config101/Bravo/README.md

# Bravo
Bravo is an 8bit computer project derived from Minimal CPU System by Carsten Herting (SLU4) and based on some concepts from Ben Eater's 8bit computer. Bravo has been developed in modules as an educational and fun  project for people who are interested in building Homebrew computers. The project is presented in a series of videos which goes through logical design, hardware development, testing and programming.

Links:
Projects YouTune Channel:
https://www.youtube.com/channel/UCHP1mo5YA1Gy9c50hQemrQw

The complete Kit or PCBs for the project are available at:
https://8bitkits.com

Minimal CPU System by Carsten Herting (SLU4)
https://www.youtube.com/channel/UCXYQcMpUBT3aaQKfmAVJNow
https://github.com/slu4coder/Minimal-UART-CPU-System
https://minimal-cpu-system.boards.net/

Ben Eater's 8bit Computer
https://eater.net/
https://www.youtube.com/channel/UCS0N5baNlQWJCUrhCEo8WlA

## Update - April 2026
All PCB Gerber files have been released as part of this repository free of charge.You now have everything needed to build the project on your own.So, If you prefer, you can order PCBs using the provided files and source the parts yourself to complete the build.

A limited number of kits are still available in our store if you want to purchase all PCBs and parts at once and support the project. Thanks to the many fellow builders who have supported this project over the last couple of years.

Happy building!
Kaveh (CONFIG101)
