config101/Bravo/Bravo-V1.0/Slides/Flash Programmer.pptx

Method 1

Flash Memories in Bravo Project

1 x SST39SF040

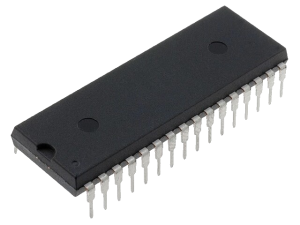
[picture p1: figure]

- 512 KB
- Memory Module

OS
Assembler

2 x SST39SF010

- 128 KB
- Control Logic

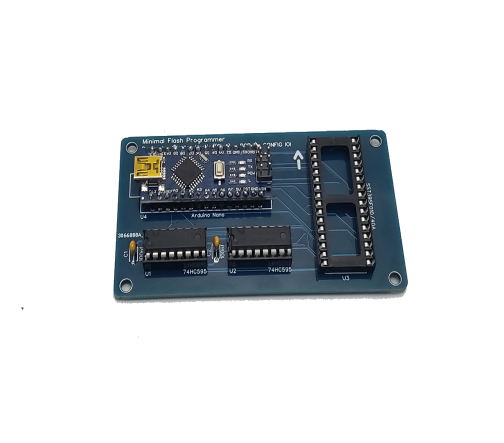
[picture p2: figure]
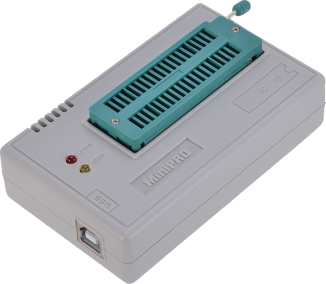
[picture p3: figure]

Micro Code

OR

Method 2

Files
Programs

File System
(Part of OS)

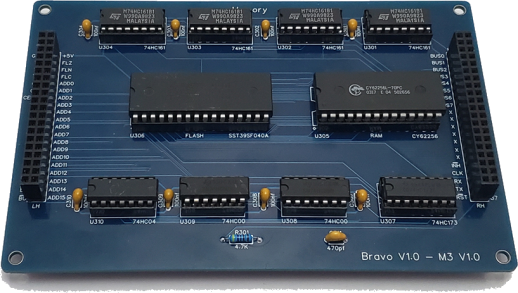
[picture p4: figure]
