config101/Bravo/Bravo-V1.0/Slides/Control Logic.pptx

## What is the Control Logic ?

Part of the computer that is outputting the Control Signals based on each specific instruction.
So far we have been using our Arduino Mega Shield to set the control signals to High/Low
We are building the control logic to output the required Control signals for each specific instruction.

## How a computer execute programs ?

Program Counter
When the computer starts, Program counter starts counting from 0
With each step, the value is put on the BUS
Signal : CO

Memory Address Register
MAR reads the value from the BUS and set the Address to the value
Signal : MI

Next Step
Signal : CE

Memory (FLASH/RAM)
Outputs the content of memory address on the BUS
Signal : RO

Flag Register
The Status of Flags saved into this register
Signal : FI

Instruction register
BUS content is the next instruction to be executed
Signal : II

Output is Addressing a ROM

Control ROM

CE ME CI CO AI AO BI BO MI RO FI EO .…..

Control Logic

Micro Step Counter
A counter that counts micro steps

## Control Logic in Bravo

Flag Register
The Status of Flags saved into this register (3 Bits)
Signal : EOFI

Instruction register
BUS content is the next instruction to be executed (6 Bits)
Signal : HI + CEME = II

Control ROMs


8 Signals

Control Logic

Micro Step Counter
A counter that counts micro steps (4 Bits)

2 x SST39SF010
Each 128 KB

MSB

8 Signals

LSB

CE ME CI CO AI AO BI BO MI RO FI EO .…..

## How Bravo execute programs ?

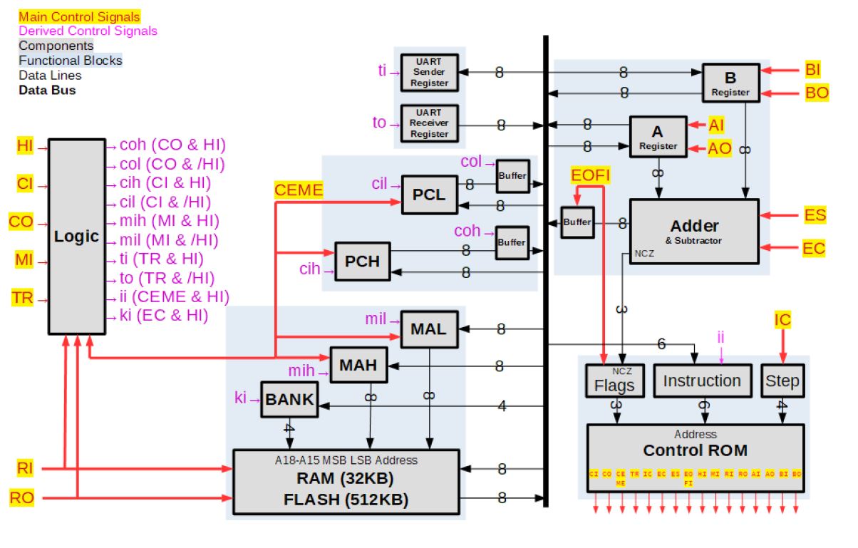
[picture p9: figure]

Fetch Instruction

1. CO , MI
2. CO, MI, HI
3. RO, HI, CEME

1. CO , MI
2. CO, MI, HI
3. RO, HI, CEME
4. RO, AI, CEME,IC

Example: LDI

## What is a program ?

2

Program
to add
X & Y

- Load X value directly into A register
- Load Y value from memory and ADD it
- Output the result

Instructions

LDI 10

Instruction

1

Operand
(Value of X)

ADD 01 80

3

OUT

Instruction
(Mnemonics used in programming)

Operand
(Memory Location, Contains Y)

LDI 10

Signals

Micro steps

1. CO , MI
2. CO, MI, HI
3. RO, HI, CEME
4. RO, AI, CEME,IC

1. Load value of 10 directly to A register
2. Load the Value of memory Address 8001(HEX) into B register
3. Output the content of the BUS

## Microcode in Bravo

+

+

0000 (4 bits)

4 + 13 bits

Total of 17 bits , addressing ROMs using 17 address lines

Flags (3 bits)
8 possible combinations

Instruction(6 bits)
64 different instructions

Micro Steps(4 bits)
16 Micro steps

Each Instruction is assigned a binary value, For Example
LDI is assigned value of 14
STA is assigned value 21
Etc..

Mnemonic | Filler Bits (4 Bits) | Flags (3 Bits) | Instruction (6 Bits) | Steps (4Bits) | | Control Signal
LDI | 0000 | 000 | 001110 | 0000 | Step0 | CO, MI
LDI | 0000 | 000 | 001110 | 0001 | Step1 | CO,MI,HI
LDI | 0000 | 000 | 001110 | 0010 | Step2 | RO,HI,CEME
LDI | 0000 | 000 | 001110 | 0011 | Step3 | RO,AI,CEME,IC
LDI | 0000 | 000 | 001110 | 0100 | Step4 | -
LDI | 0000 | 000 | 001110 | 0101 | …. | -

## Microcode in Bravo

LDA 101001 Step0 0000 CO|MI
LDA 101001 Step1 0001 CO|MI|HI
LDA 101001 Step2 0010 RO|HI|CEME
LDA 101001 Step3 0011 RO|BI|CEME
LDA 101001 Step15 1111 .

LDA 101001 Step0 0000 CO|MI
LDA 101001 Step1 0001 CO|MI|HI
LDA 101001 Step2 0010 RO|HI|CEME
LDA 101001 Step3 0011 RO|BI|CEME
LDA 101001 Step15 1111 .

LDA 101001 Step0 0000 CO|MI
LDA 101001 Step1 0001 CO|MI|HI
LDA 101001 Step2 0010 RO|HI|CEME
LDA 101001 Step3 0011 RO|BI|CEME
LDA 101001 Step15 1111 .

3 Flags
(8 combinations)

000
001
010

x

x

Flags (3 bits)
8 possible combinations

Instruction(6 bits)
64 different instructions

Micro Steps(4 bits)
16 Micro steps

8192 Total Micro Instructions , 8K
