config101/Bravo/Bravo-V1.0/BOM/Bravo_V1.0_BOM.xlsx

Item | Description | Footprint | QTY
74HC00 | IC | DIP-14_W7.62MM_SOCKET | 6
74HC02 | IC | DIP-14_W7.62MM_SOCKET | 1
74HC04 | IC | DIP-14_W7.62MM_SOCKET | 4
74HC08 | IC | DIP-14_W7.62MM_SOCKET | 3
74HC161 | IC | DIP-16_W7.62MM_SOCKET | 12
74HC164 | IC | DIP-14_W7.62MM_SOCKET | 2
74HC165 | IC | DIP-16_W7.62MM_SOCKET | 2
74HC173 | IC | DIP-16_W7.62MM_SOCKET | 6
74HC174D | IC | DIP-16_W7.62MM_SOCKET | 1
74HC193 | IC | DIP-16_W7.62MM_SOCKET | 1
74HC245 | IC | DIP-20-2.54MM | 6
74HC283 | IC | DIP-16_W7.62MM_SOCKET | 2
74HC86 | IC | DIP-14_W7.62MM_SOCKET | 2
Ceramic Capacitor 100nf | Ceramic Capacitor | CAP-TH_L4.0-W2.5-P5.00-D1.0 | 42
Ceramic Capacitor 470pf | Ceramic Capacitor | CAP-TH_L4.0-W2.5-P5.00-D1.0 | 2
Ceramic Capacitor 100pf | Ceramic Capacitor | CAP-TH_L4.0-W2.5-P5.00-D1.1 | 1
Electrolytic Capacitor 47 mf | Electrolytic Capacitor | CAP-TH_BD5.0-P2.50-D1.0-FD | 1
CRYSTAL 3.6864 MHz | Crystal | CRYSTAL 1MHZ | 1
CY62256 | RAM | PDIP-28_L37.0-W13.5-P2.54-LS15.6-BL | 1
DIP 14 IC Socket | IC Socket | DIP-14_W7.62MM_SOCKET | 19
DIP 16 IC Socket | IC Socket | DIP-16_W7.62MM_SOCKET | 24
DIP 20 IC Socket | IC Socket | DIP-20-2.54MM | 6
DIP 28 IC Socket | IC Socket | PDIP-28_L37.0-W13.5-P2.54-LS15.6-BL | 1
DIP 32 IC Socket | IC Socket | PDIP-32_L42.0-W13.7-P2.54-LS15.2-BL | 3
Header Female 2x20 | Header Female 2x20 | HEADER-2X20-2.54 | 2
Header Female Stackable 2x20 (40 pins) - Long Pins | Header Female 2x20 Long | HEADER-2X20-2.54 | 12
Header Male 1x40 | Header Male 1x40 | Header Male 1x40 | 5
Header Pin Jumper | Clock Rate Selector - Jumper |  | 1
LED 5 MM BLUE | LED | LED5MM | 20
LED 5 MM GREEN | LED | LED5MM | 10
LED 5 MM RED | LED | LED5MM | 20
LED 5 MM YELLOW | LED | LED5MM | 20
Resistor 4.7K Ohm | Resistor | AXIAL-0.4 | 4
Resistor Array 470 Ohm 8 Resistors (9 Pins)-Bussed | Buss Resitor Array | HDR-M-2.54_1X9 | 9
SST39SF010A | ROM FLASH (LSB - MSB) | DIP-32_600MIL | 2
SST39SF040A | ROM FLASH Storage | PDIP-32_L42.0-W13.7-P2.54-LS15.2-BL | 1
Tactile Switch | System Reset Tactile Switch | TACTILE-PTH | 4
PCB | PCB |  | 7
FT232RL FTDI Mini USB to TTL Serial |  |  | 1
Nylon Hex Standoff Female to Female (M3X20) | Spacer |  | 4
Nylon Hex Standoff M3 Female to Male 6mm+6mm | Spacer |  | 4
