config101/Bravo/(threads)

Thread 1 (2022-01-22):

Ref: Microcode bug in ADB

paulscottrobson, 2022-01-22:
As per https://github.com/slu4coder/Minimal-UART-CPU-System/issues/3

Closed 2022-03-22.

Thread 2 (2022-03-21):

Releasing PCB layout files?

joelburton, 2022-03-21:
This is a really interesting project, and I've been enjoying the videos a lot.

Given the educational nature of this (and the fact you've licensed it as CC0), I was hoping to be able to find the PCB design files. It's helpful for me when debugging something I've put together, and it can also help us connect the physical boards to the schematics. It looks like the EasyEDA files don't have the PCBs in them (or perhaps I'm not looking at them properly?)

If your goal is to generate income from sales of the PCBs, I understand & can respect that. Perhaps just some screenshots of the boards and the routing can be provided? That can discourage people from bypassing buying them, but provide a lot of the understanding-the-system benefits.

config101, 2022-03-22:
Hi Joel,
Thanks for your comment and I'm glad you are enjoying the videos.
You are right, the PCB files are not included in the EasyEDA files. 
While the project and all related circuits are licensed under Creative Commons, the PCBs are not. At this point, PCBs are commercial products sold at www.8bitkits.com.
This is really not about generating income from the project.The proceeds from the sale of PCBs/Kits are going into supporting current/future projects. Developing these PCBs has taken numerous hours of work and I went through 3 different prototypes/revisions over several months to come up with the final version that is all accurate and bug free.
Now, I have a plan to eventually release all the files which requires removing commercial markings from PCBs. That may happen in near future.
Here was my thought; if someone is hands on enough with building PCBs, all the schematics are available to do so. but If someone does not want to go that route, the PCBs are available for purchase and frankly the price that I'm offering the PCB sets at 8bitkits.com would probably be 30 to 40 percent less than cost of ordering PCBs from china (after cost of PCBs and shipping costs).
Anyhow, if you need the screenshots of the PCBs, I probably can take them. Just send me an email : support at 8bitkits.com and I will reply to that.
Thanks
CONFIG IOI 
      
On 3/20/2022 5:59:03 PM, Joel Burton ***@***.***> wrote:
This is a really interesting project, and I've been enjoying the videos a lot.
Given the educational nature of this (and the fact you've licensed it as CC0), I was hoping to be able to find the PCB design files. It's helpful for me when debugging something I've put together, and it can also help us connect the physical boards to the schematics. It looks like the EasyEDA files don't have the PCBs in them (or perhaps I'm not looking at them properly?)
If your goal is to generate income from sales of the PCBs, I understand & can respect that. Perhaps just some screenshots of the boards and the routing can be provided? That can discourage people from bypassing buying them, but provide a lot of the understanding-the-system benefits.
—
Reply to this email directly, view it on GitHub [https://github.com/config101/Bravo/issues/2], or unsubscribe [https://github.com/notifications/unsubscribe-auth/AW7G3VQOFPYSAAGVJIUGZDDVA7CVNANCNFSM5RGJHXAQ].
Triage notifications on the go with GitHub Mobile for iOS [https://apps.apple.com/app/apple-store/id1477376905?ct=notification-email&amp;mt=8&amp;pt=524675] or Android [https://play.google.com/store/apps/details?id=com.github.android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].
You are receiving this because you are subscribed to this thread.Message ID: ***@***.***>
[25719101-5271-41e2-b09a-881d1d001396]

Closed 2022-03-22.
