config101/Bravo/Bravo-V1.0/Schematic-PDFs/Schematic_Minimal Flash Programmer_2021_12_21.pdf

A | A

1

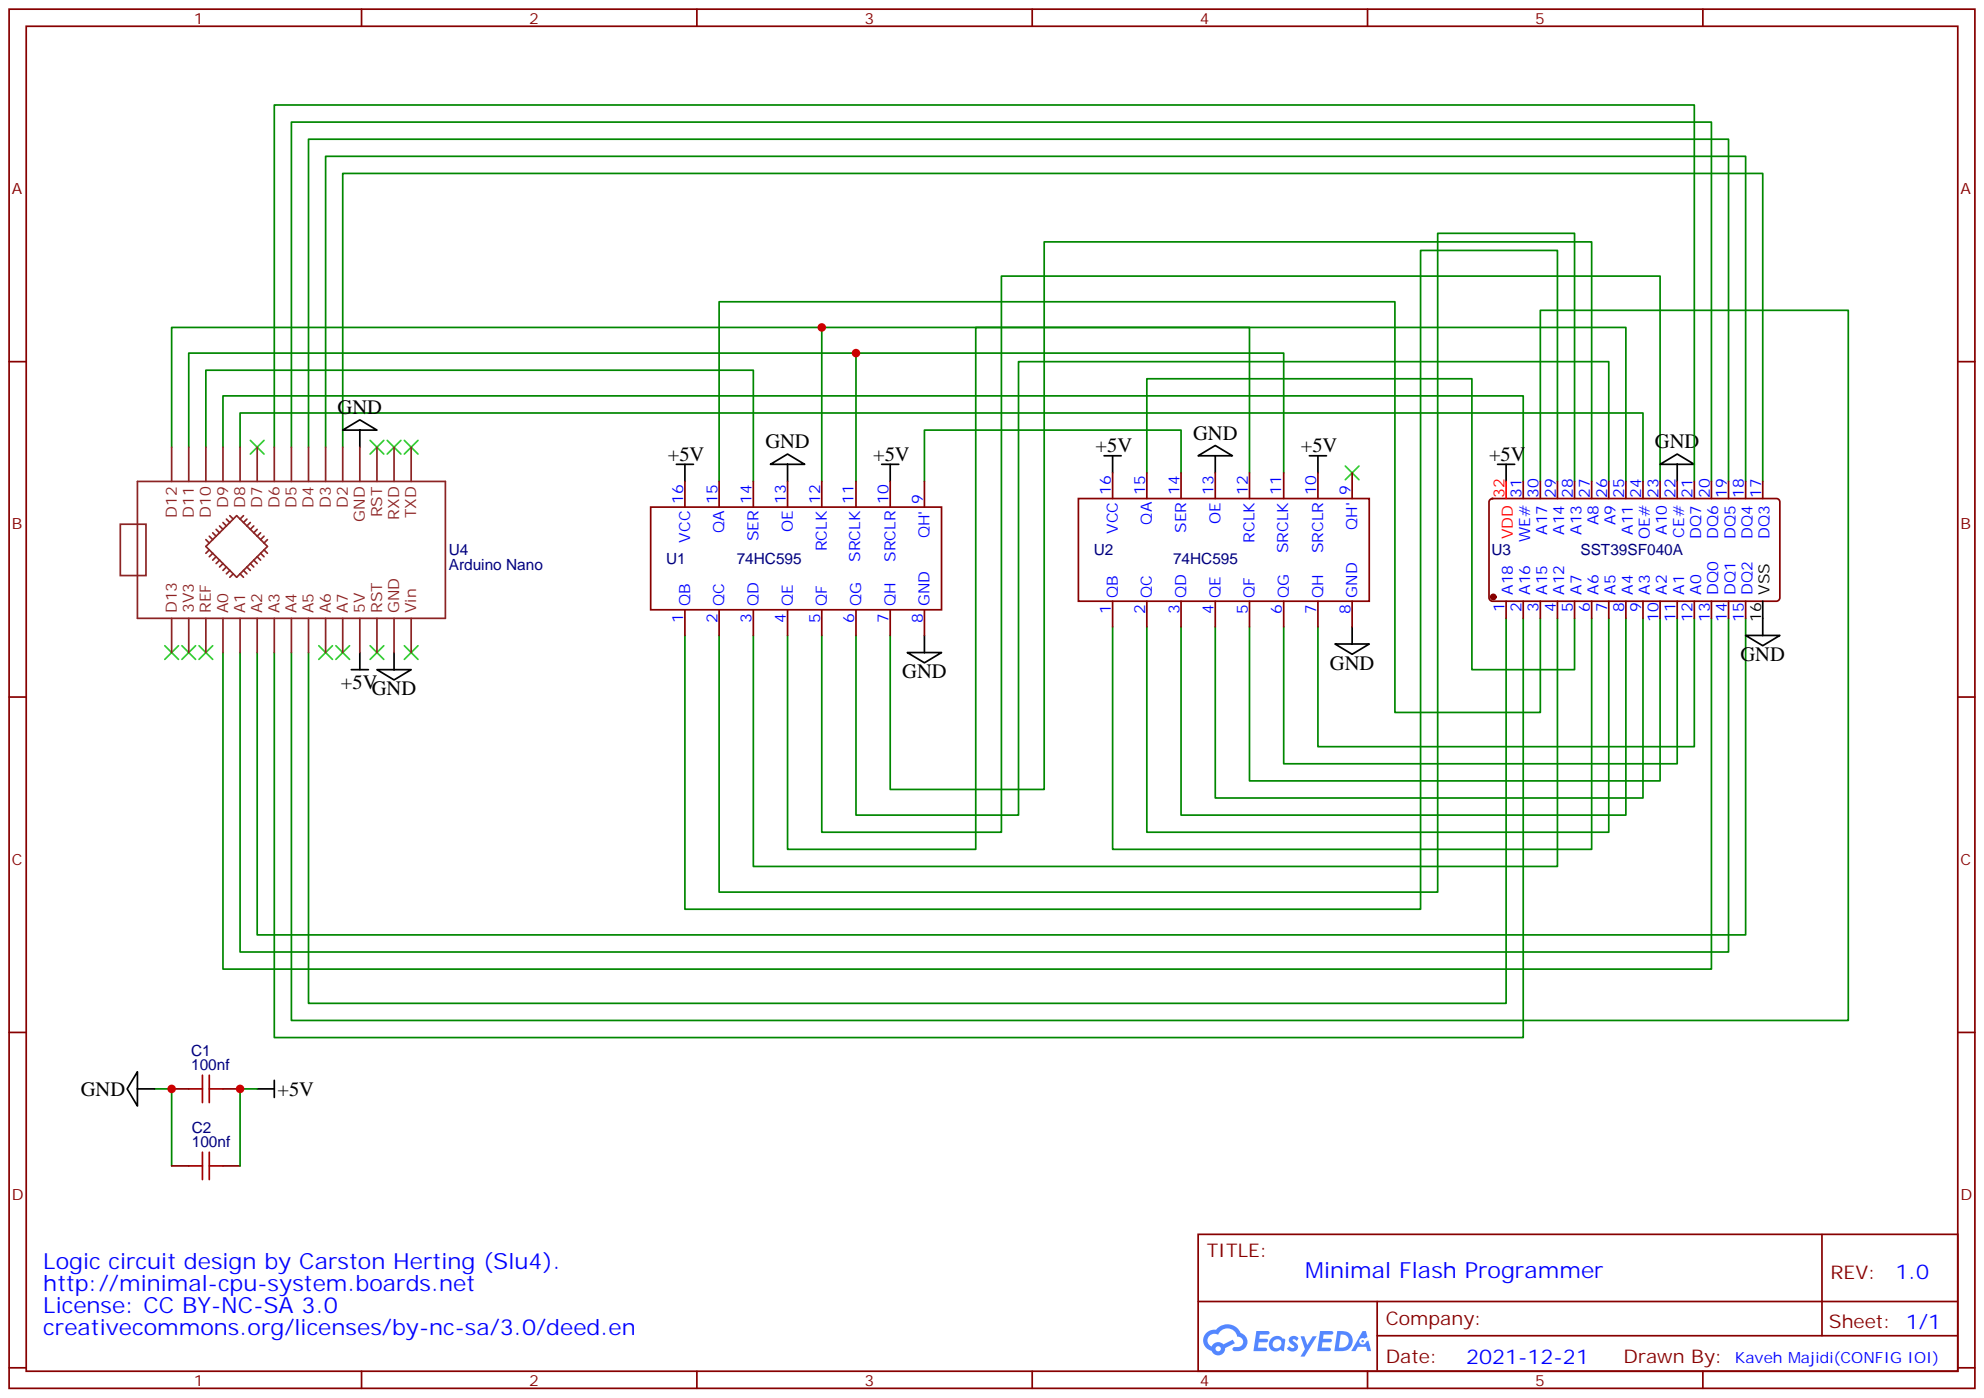
[picture p10: page 1]

VSS 16 DQ3 17 DQ4 18 DQ5 19 DQ6 20 DQ7 21 CE# 22 A10 23 OE# 24 A11 25 A9 26 A8 27 A13 28 A14 29 A17 30 WE# 31 VDD 32

Logic circuit design by Carston Herting (Slu4).
http://minimal-cpu-system.boards.net
License: CC BY-NC-SA 3.0
creativecommons.org/licenses/by-nc-sa/3.0/deed.en

Drawn By: Kaveh Majidi(CONFIG IOI)
