config101/Bravo/Bravo-V1.0/Schematic-PDFs/Schematic_Bravo-M1-Clock-and-Program Counter_2021-12-18.pdf

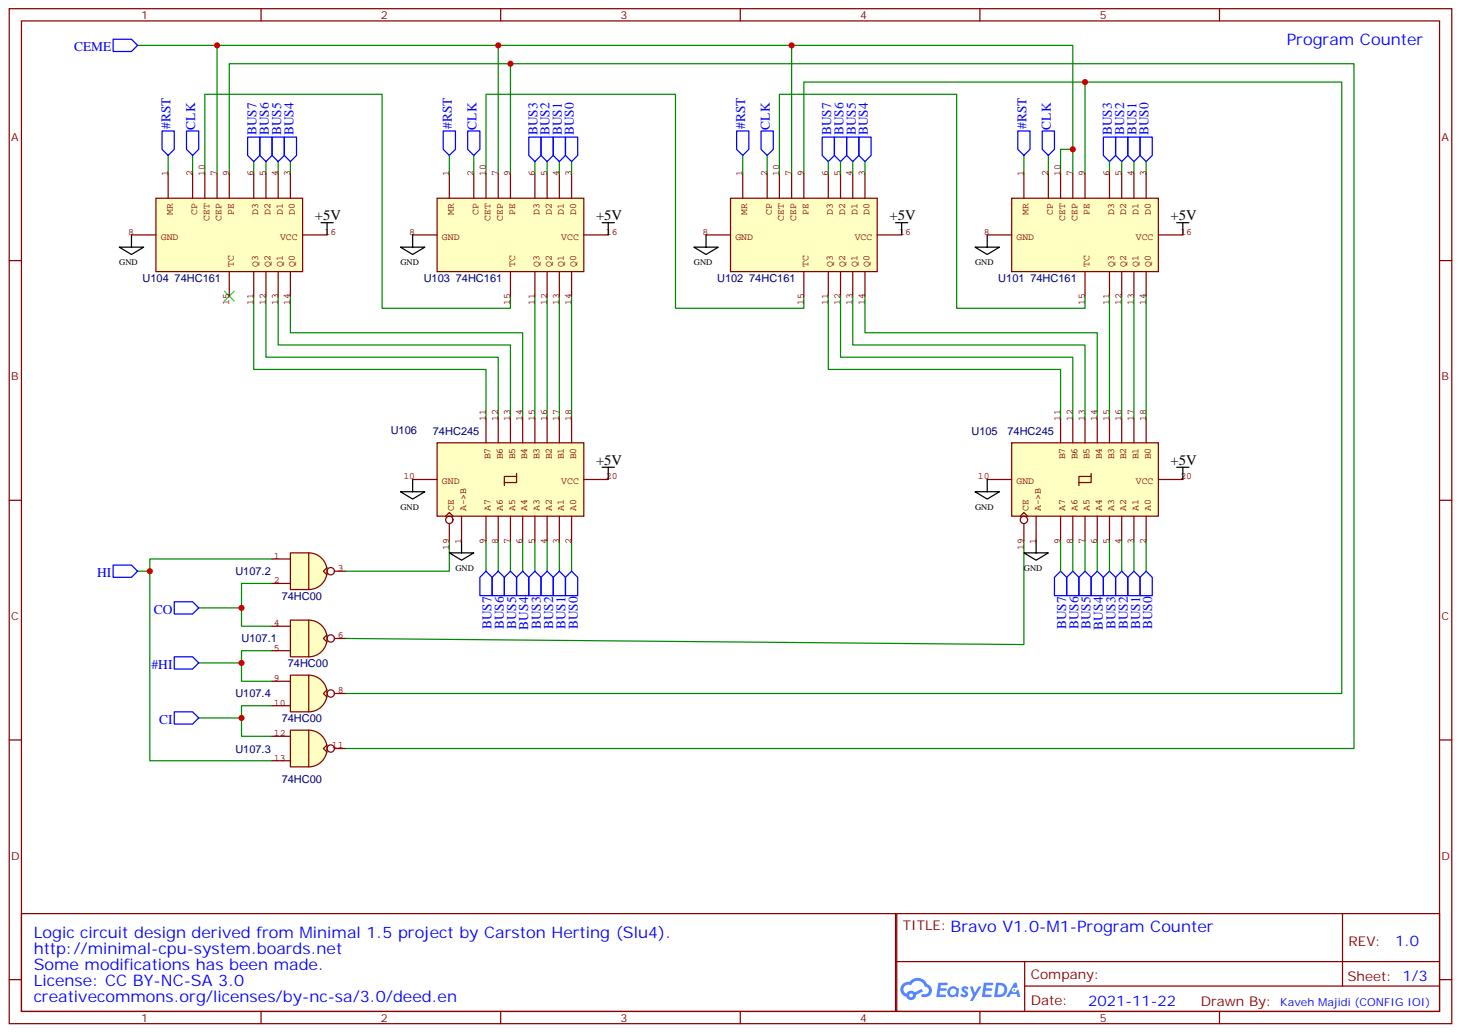
[picture p16: page 1]

TITLE: Bravo V1.0-M1-Program Counter

Logic circuit design derived from Minimal 1.5 project by Carston Herting (Slu4).
http://minimal-cpu-system.boards.net
Some modifications has been made.
License: CC BY-NC-SA 3.0
creativecommons.org/licenses/by-nc-sa/3.0/deed.en

Drawn By: Kaveh Majidi (CONFIG IOI)

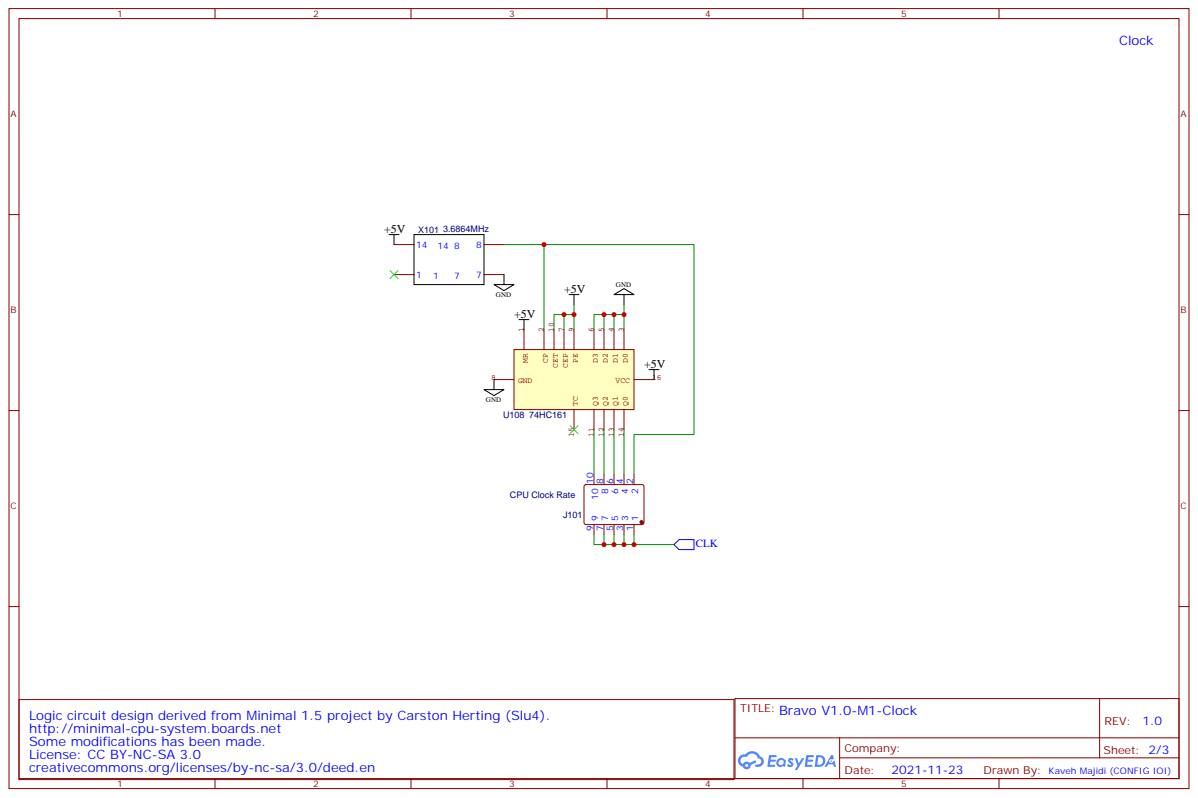
[picture p17: page 2]
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

39 39 40 40 38 38 36 36 34 34 32 32 30 30 28 28 26 26 24 24 22 22 20 20 18 18 16 16 14 14 12 12 10 10 8

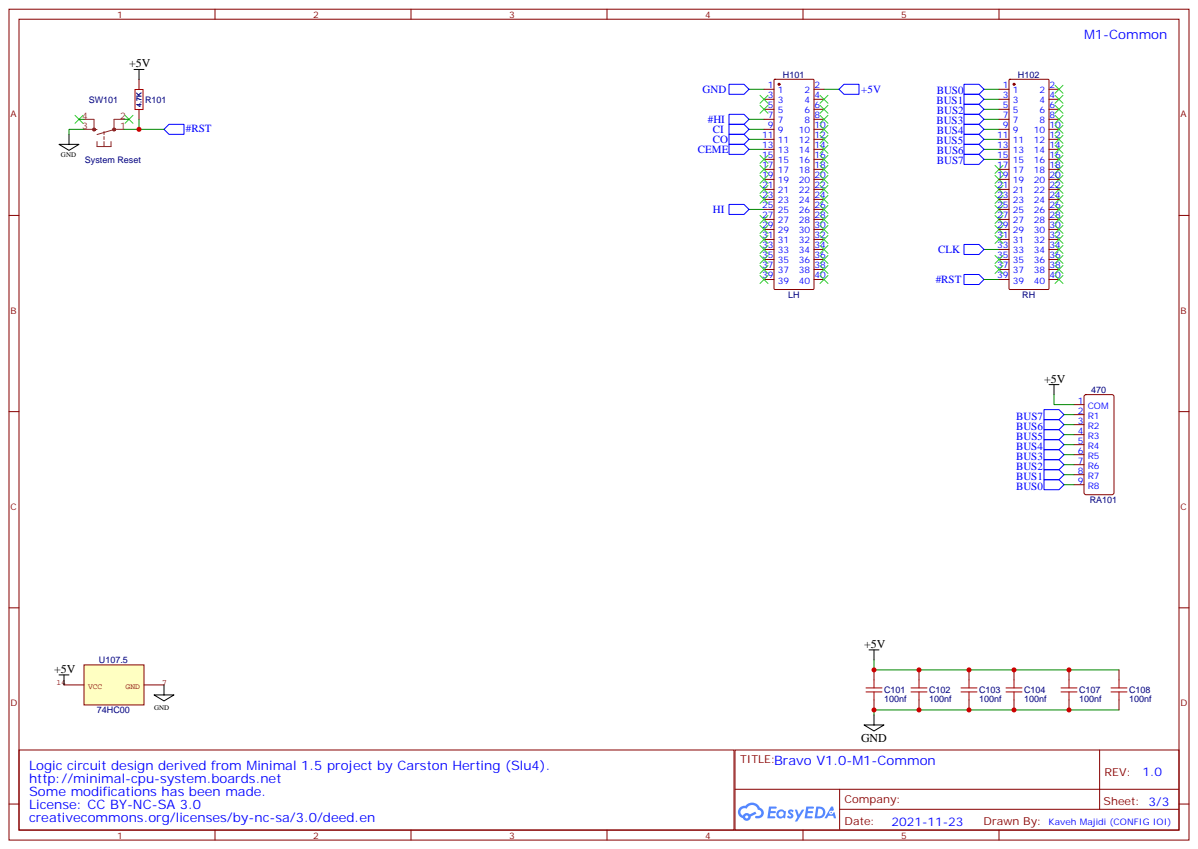
[picture p18: page 3]
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
