config101/Bravo/Bravo-V1.0/Schematic-PDFs/Schematic_Bravo-M3-Memory_2021-12-18.pdf

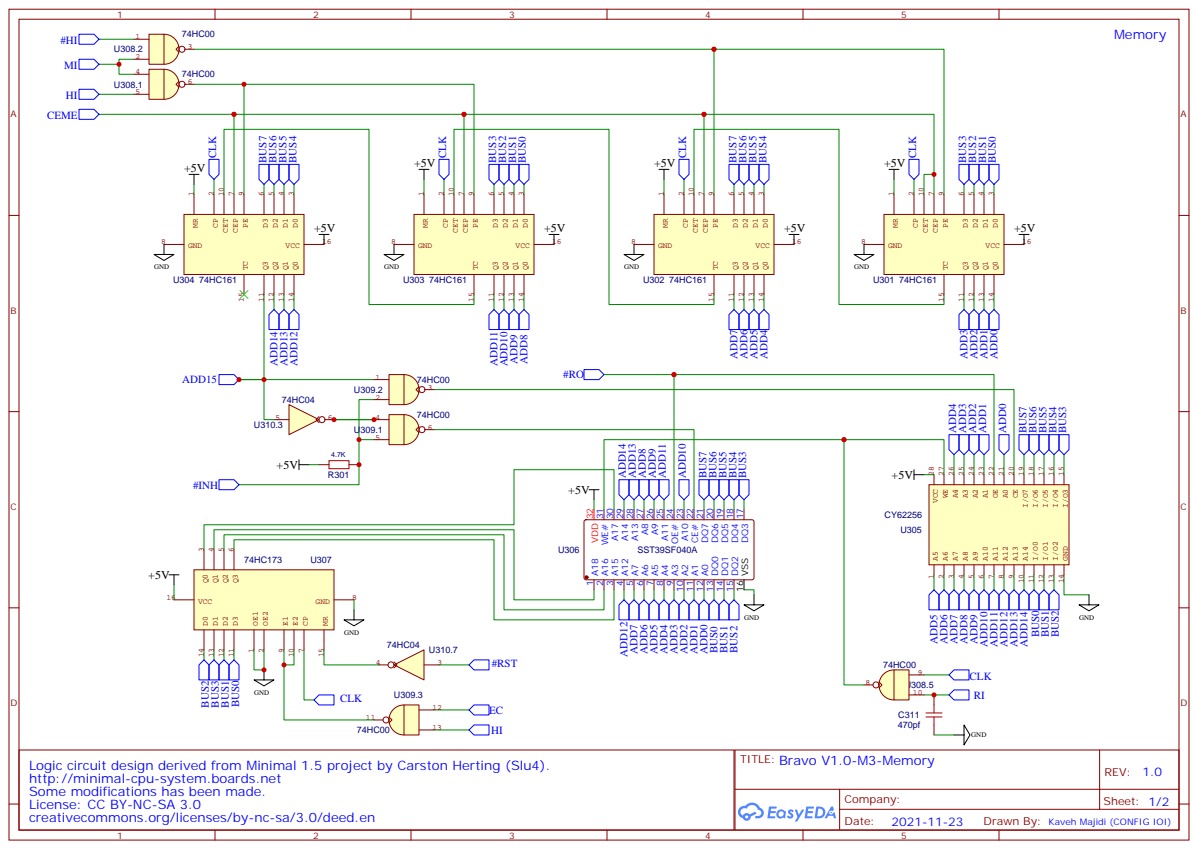
[picture p19: page 1]

VSS 16 DQ3 17 DQ4 18 DQ5 19 DQ6 20 DQ7 21 CE# 22 A10 23 OE# 24 A11 25 A9 26 A8 27 A13 28 A14 29 A17 30 WE# 31 VDD 32

Logic circuit design derived from Minimal 1.5 project by Carston Herting (Slu4).
http://minimal-cpu-system.boards.net
Some modifications has been made.
License: CC BY-NC-SA 3.0
creativecommons.org/licenses/by-nc-sa/3.0/deed.en

Drawn By: Kaveh Majidi (CONFIG IOI)

39 39 40 40 38 38 36 36 34 34 32 32 30 30 28 28 26 26 24 24 22 22 20 20 18 18 16 16 14 14 12 12 10 10 8

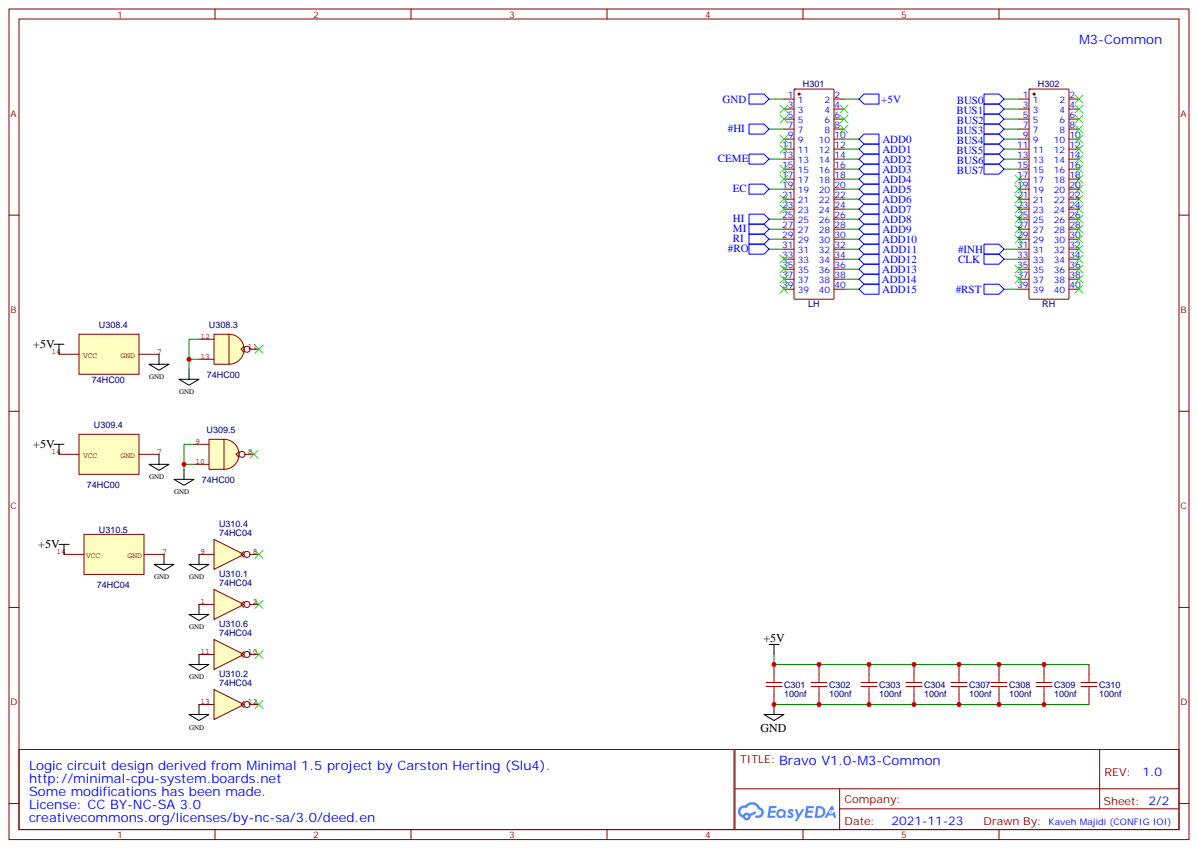
[picture p20: page 2]
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

Drawn By: Kaveh Majidi (CONFIG IOI)
