config101/Bravo/Bravo-V1.0/Schematic-PDFs/Schematic_Bravo-M6-LED Board_2021-12-18.pdf

A register | B Register

## Address BUS

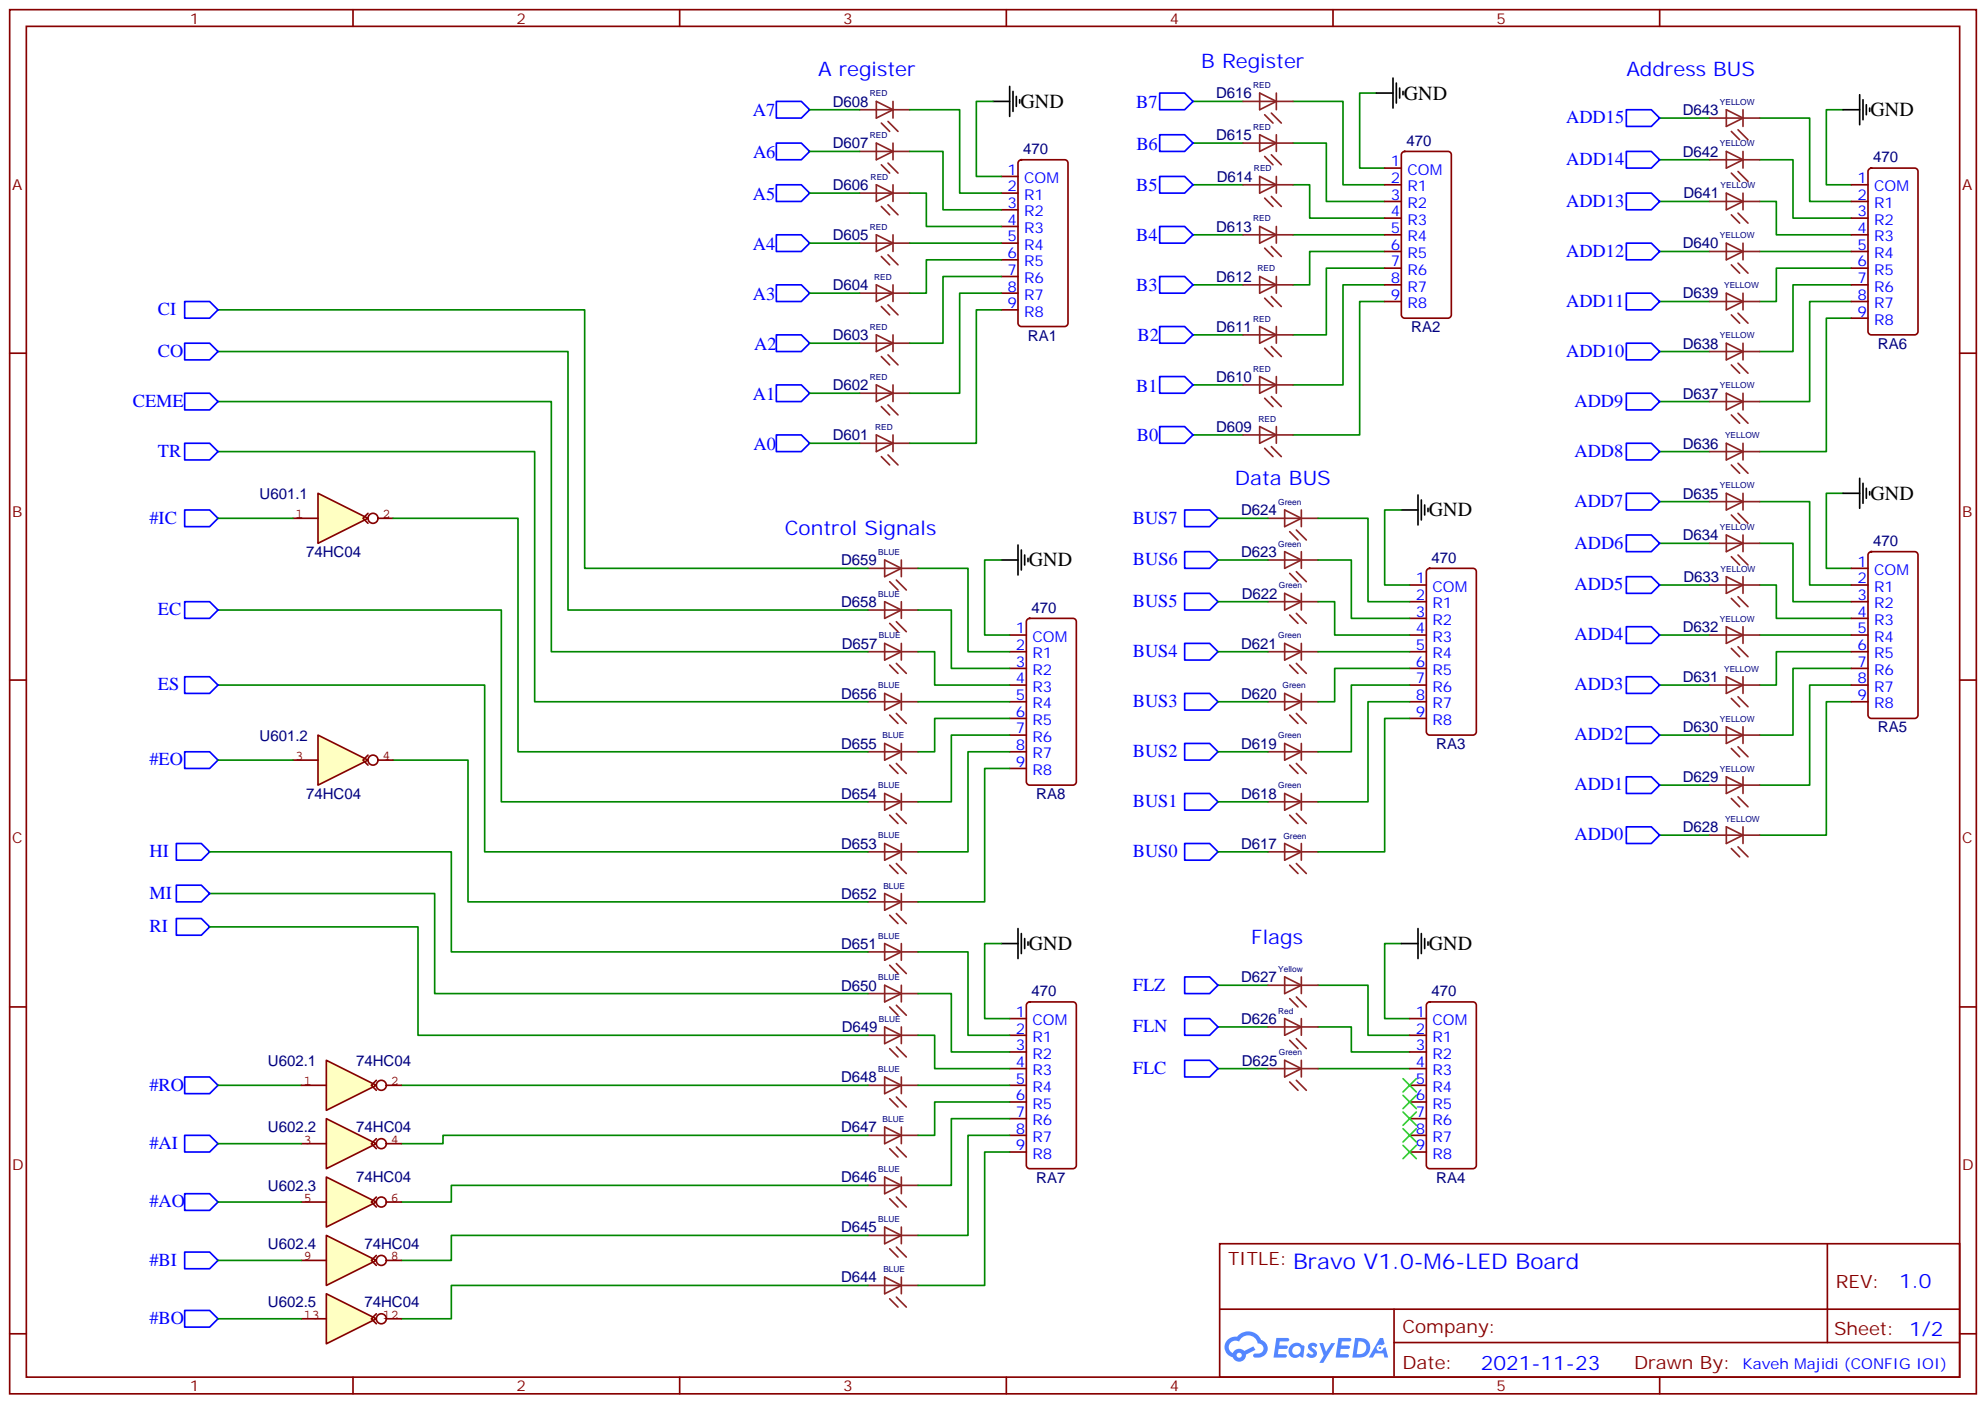
[picture p26: page 1]

TITLE: Bravo V1.0-M6-LED Board

Drawn By: Kaveh Majidi (CONFIG IOI)

39 39 | 40 40 38 38 36 36 34 34 32 32 30 30 28 28 26 26 24 24 22 22 20 20 18 18 16 16 14 14 12 12 10 10 8
39 39 | 40 40 38 38 36 36 34 34 32 32 30 30 28 28 26 26 24 24 22 22 20 20 18 18 16 16 14 14 12 12 10 10 8

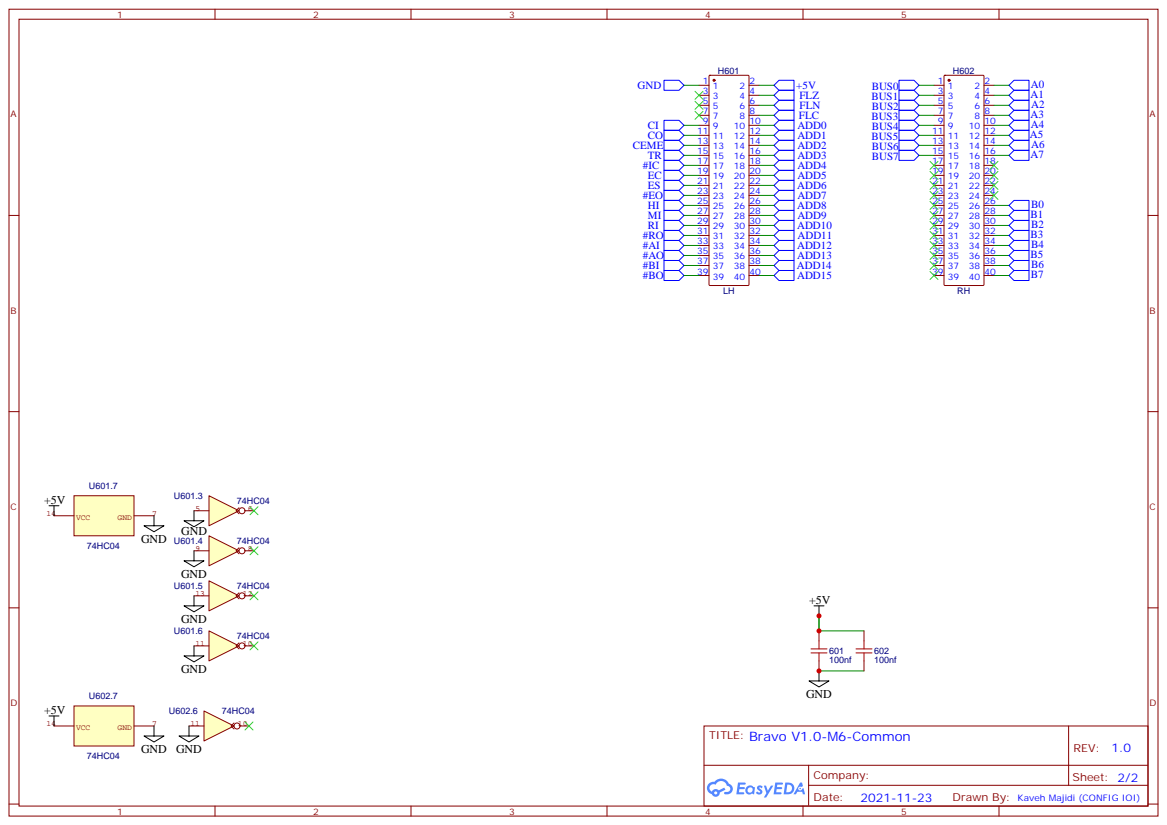
[picture p27: page 2]

Drawn By: Kaveh Majidi (CONFIG IOI)
