config101/Bravo/Bravo-V1.0/Schematic-PDFs/Schematic_Bravo-M7-Arduino Mega Shield_2021-12-18.pdf

## Arduino Shield

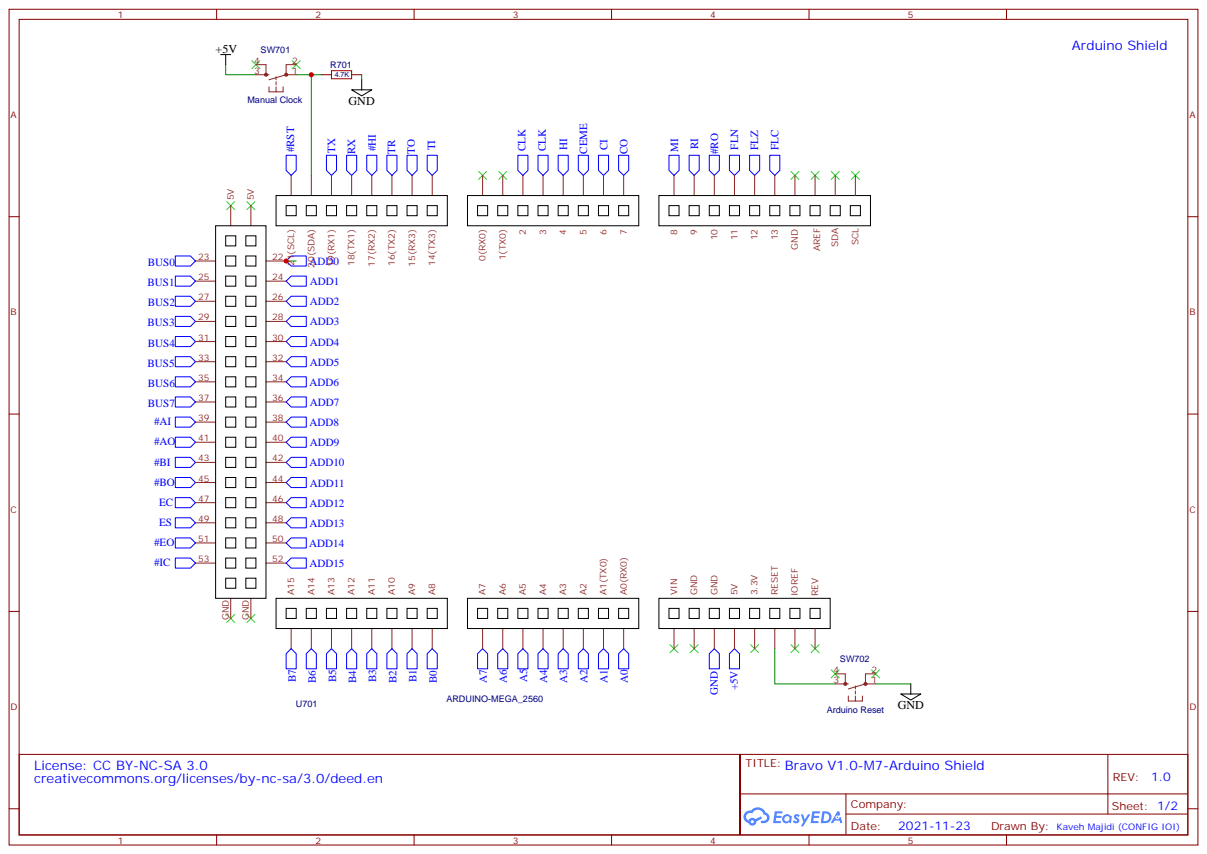
[picture p28: page 1]

License: CC BY-NC-SA 3.0
creativecommons.org/licenses/by-nc-sa/3.0/deed.en

TITLE: Bravo V1.0-M7-Arduino Shield

Drawn By: Kaveh Majidi (CONFIG IOI)

39 39 40 40 38 38 36 36 34 34 32 32 30 30 28 28 26 26 24 24 22 22 20 20 18 18 16 16 14 14 12 12 10 10 8

## M7-Common

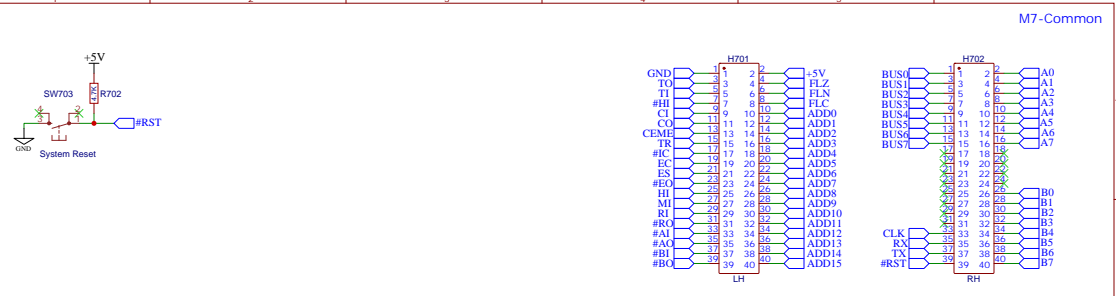
[picture p29: page 2]
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

Drawn By: Kaveh Majidi (CONFIG IOI)
