config101/Bravo/Bravo-V1.0/Schematic-PDFs/Schematic_Bravo-M2-ALU-Registers_2021-12-18.pdf

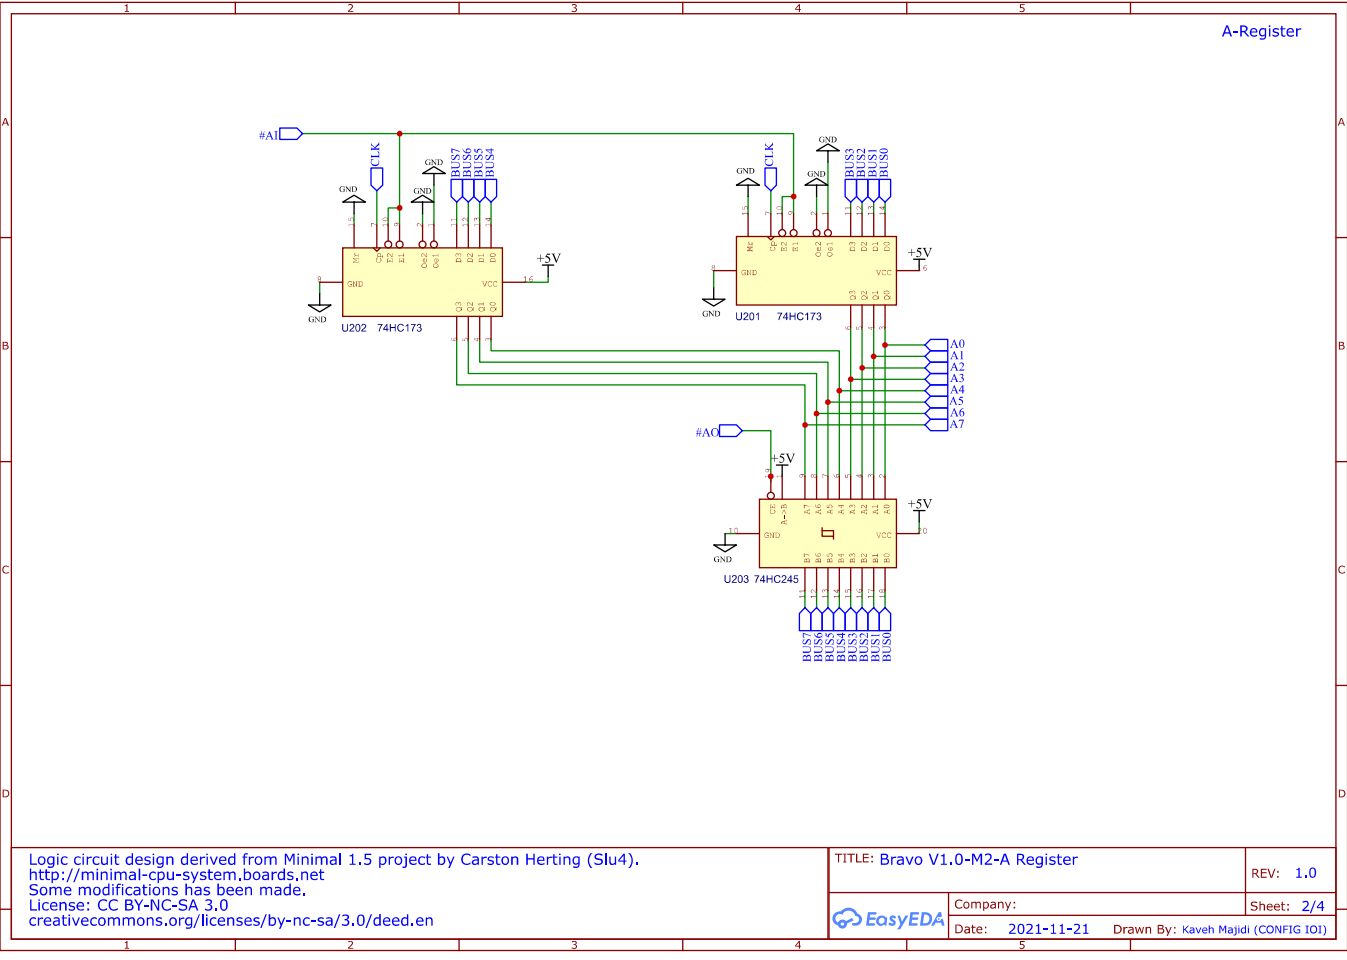
[picture p30: page 1]

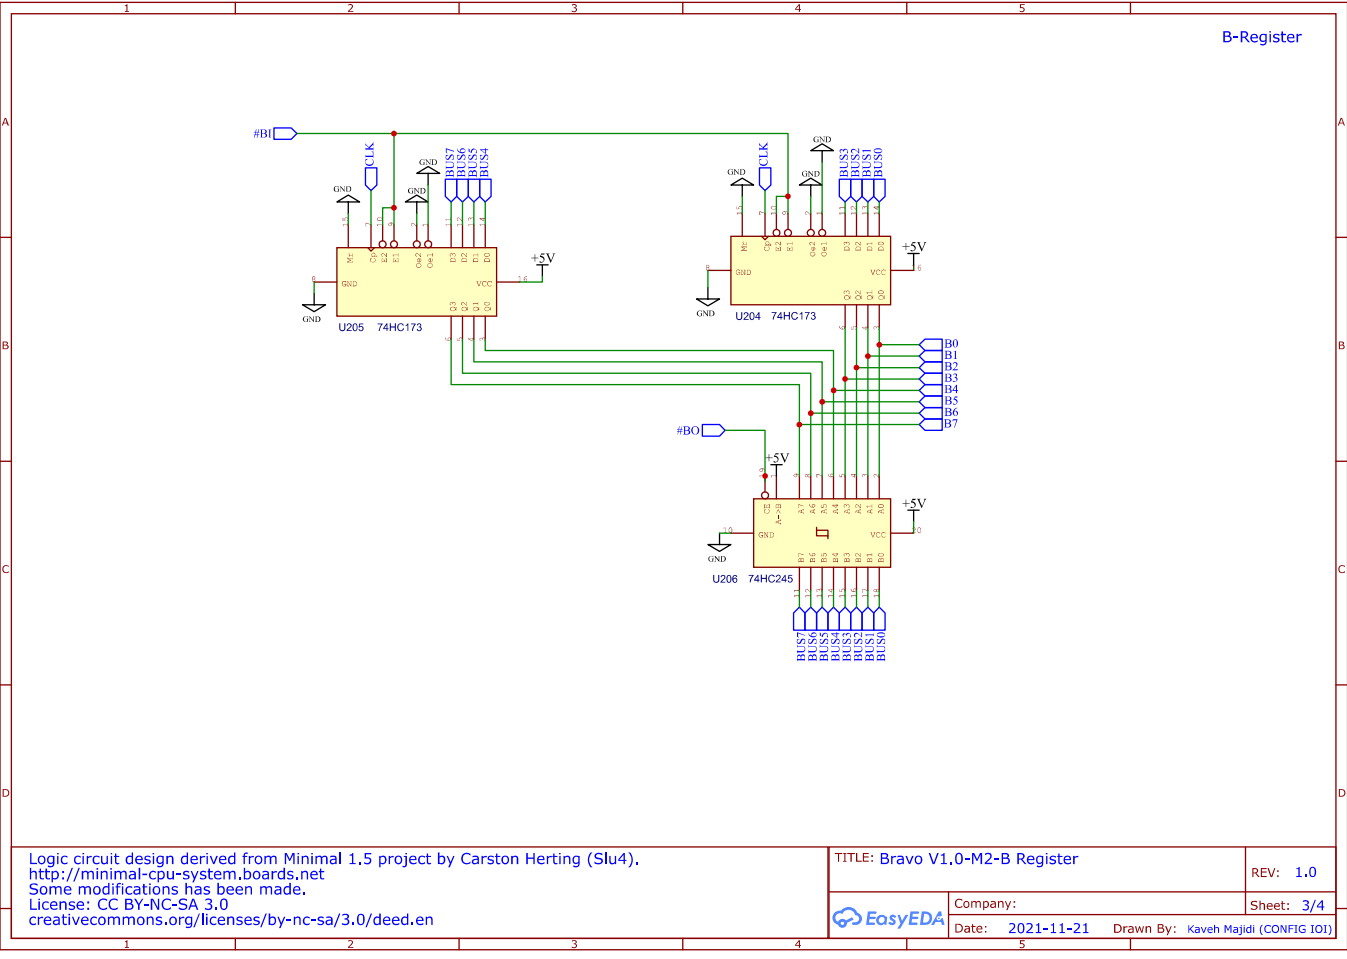
[picture p31: page 2]

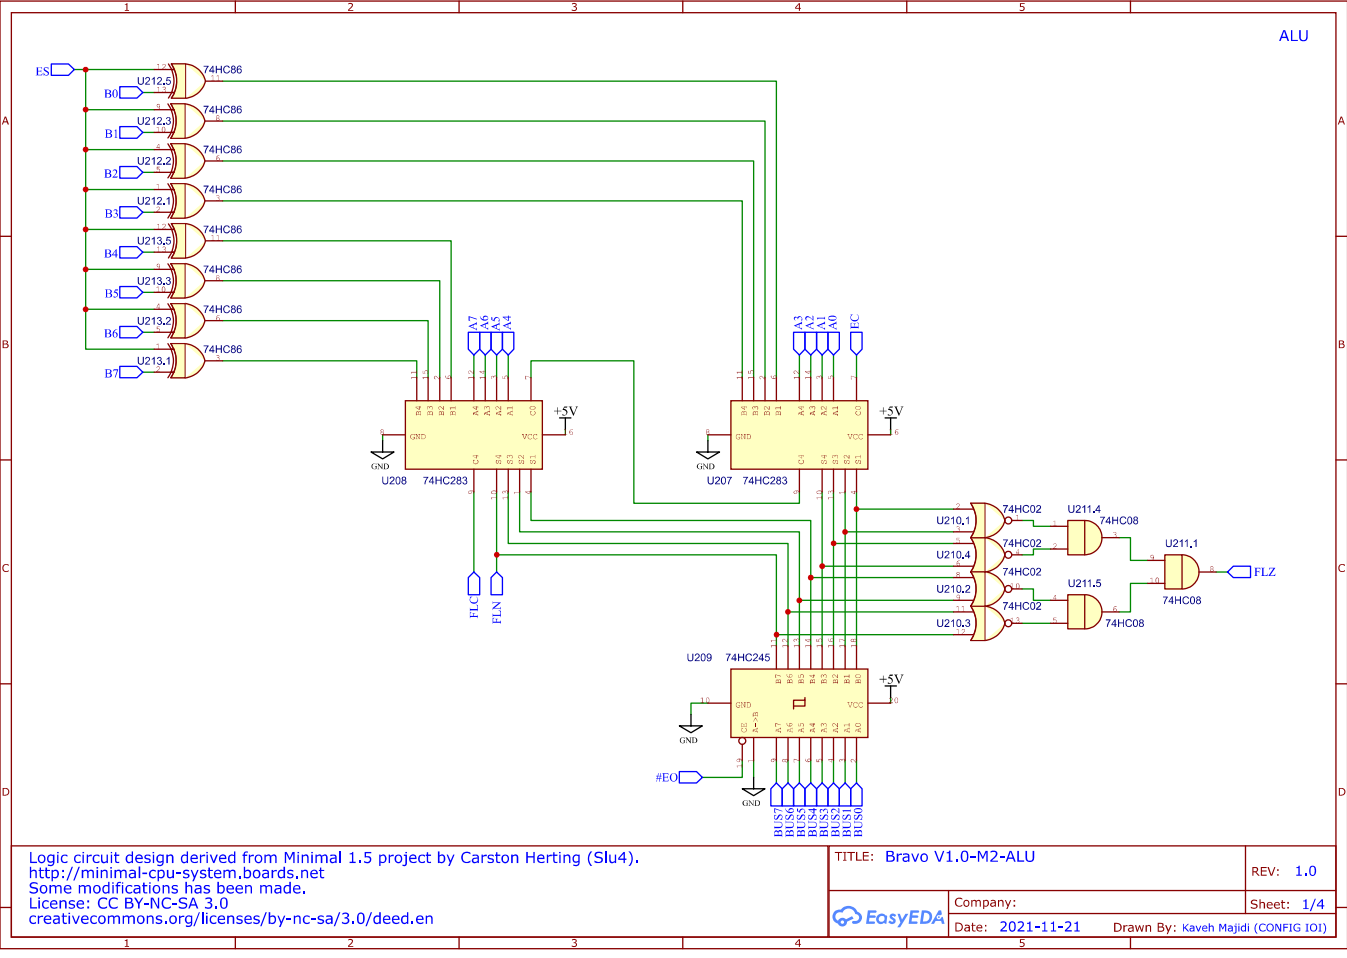
[picture p32: page 3]

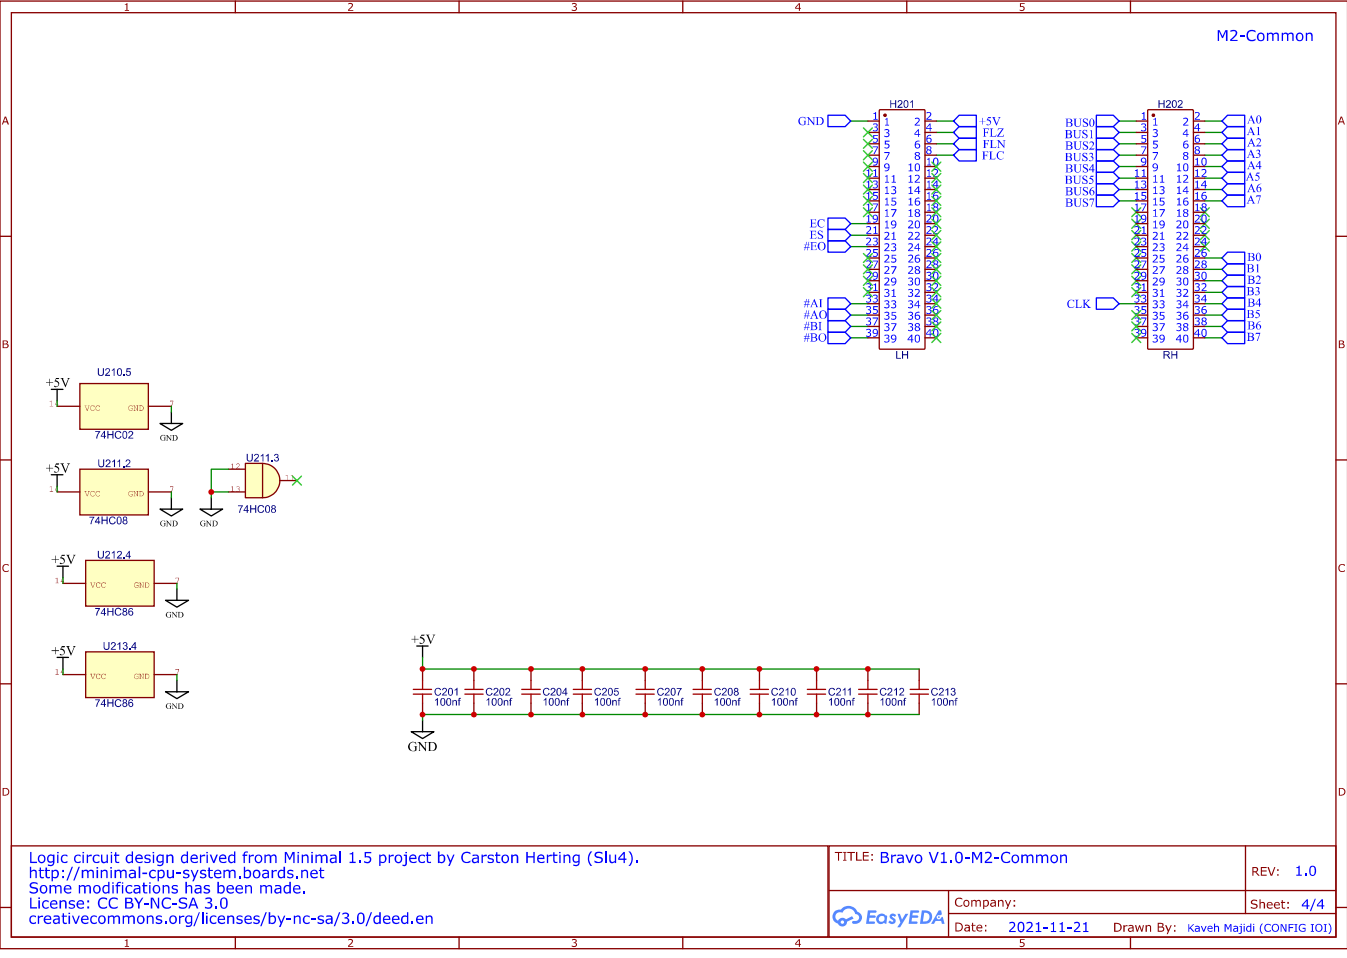
[picture p33: page 4]
