config101/Bravo/Bravo-V1.0/Arduino Sketches/Part13_Control_Logic/Control_logic_test.py

msb_data = bytearray([
  0x89,0x49,0x29,0x19,0x01,0x0D,0x0B,0x08,0x09,0x09,0x09,0x09,0x09,0x09,0x09,0x09,
  ])
msb_rom = msb_data + bytearray([0xff] * (131072 - len(msb_data)))

with open("msb_rom.bin", "wb") as out_file:
  out_file.write(msb_rom)

lsb_data = bytearray([
  0x1F,0x1F,0x1F,0x1F,0x1F,0x1F,0x1F,0x1F,0x9F,0x5F,0x3F,0x0F,0x17,0x1B,0x1D,0x1E,
  ])
lsb_rom = lsb_data + bytearray([0xff] * (131072 - len(lsb_data)))

with open("lsb_rom.bin", "wb") as out_file:
  out_file.write(lsb_rom)
